OPEnSLab-OSU/ECSense/EC Sense - Smartrock (Schematic).pdf

# 10k 100k GND MAX4678EUE+

## C14 R5 R6

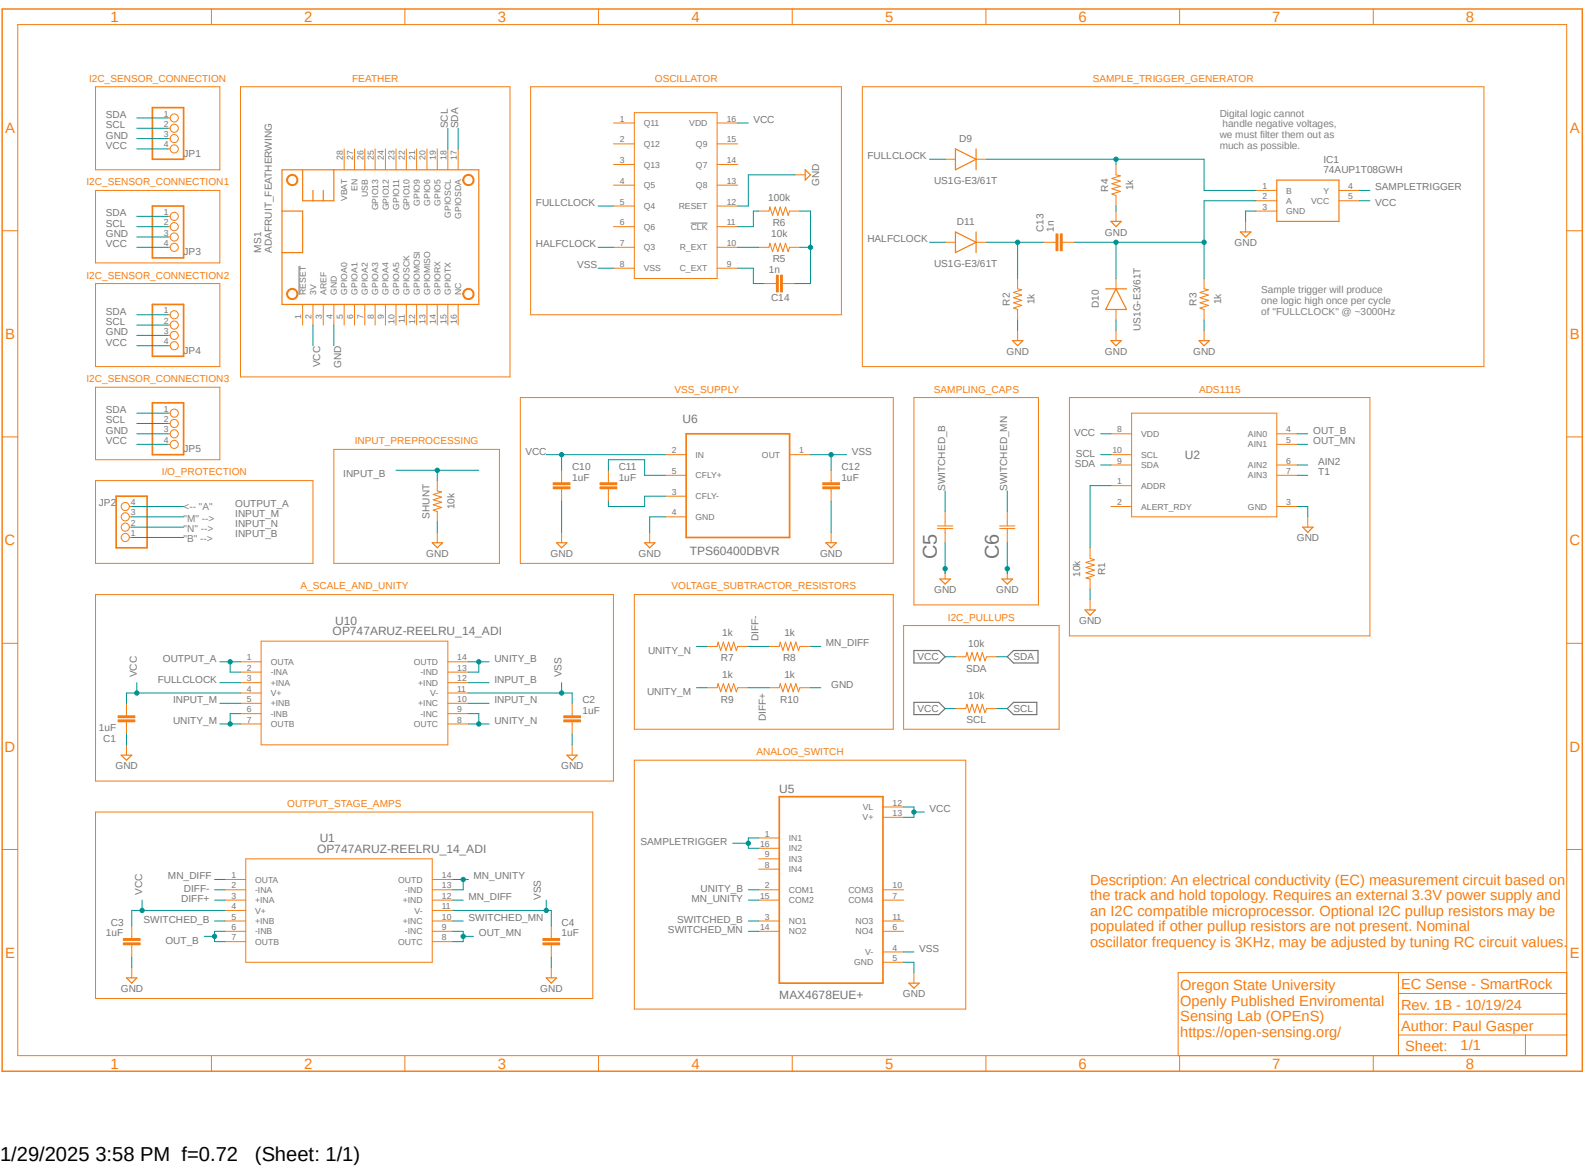
[picture p1: page 1]

Digital logic cannot
handle negative voltages, we must filter them out as much as possible.

9 GPIOA5 10 GPIOMISO 13 GPIOMOSI 12 GPIORX 14 GPIOSCK 11 GPIOSCL 18 GPIOSDA 17 GPIOTX 15 NC 16 USB 26 VBAT 28 C5 C6 U2 ADDR 1 ALERT_RDY 2 GND 3 AIN0 4 AIN1 5 AIN2 6 AIN3 7 VDD 8 SDA 9 SCL 10 R1

Sample trigger will produce
one logic high once per cycle of "FULLCLOCK" @ ~3000Hz

Description: An electrical conductivity (EC) measurement circuit based on
the track and hold topology. Requires an external 3.3V power supply and
an I2C compatible microprocessor. Optional I2C pullup resistors may be
populated if other pullup resistors are not present. Nominal
oscillator frequency is 3KHz, may be adjusted by tuning RC circuit values.

Oregon State University
Openly Published Enviromental
Sensing Lab (OPEnS)
https://open-sensing.org/
